andrastantos/jtag_2232h/ALTIUM_EMBEDDED_MODELS/ASE-xxxMHZ.stp

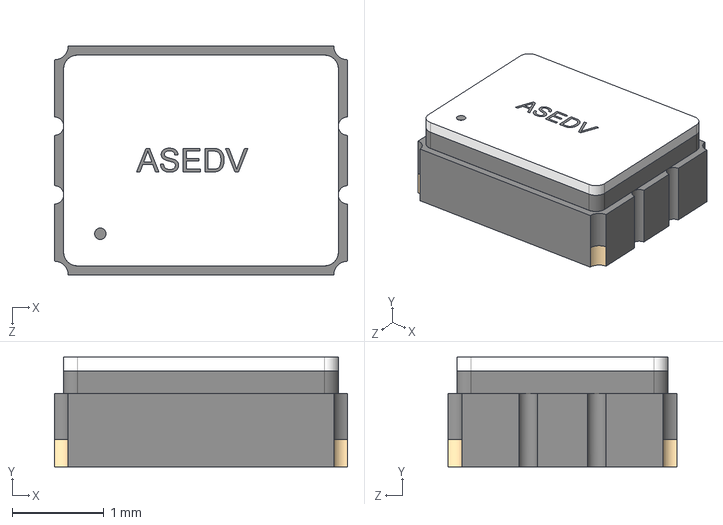
[picture p1: CAD file, 2024-08-22]
ALTIUM_EMBEDDED_MODELS/ASE-xxxMHZ.stp
3.20 x 1.20 x 2.50 mm
