andrastantos/jtag_2232h/ALTIUM_EMBEDDED_MODELS/APTB1615.STEP

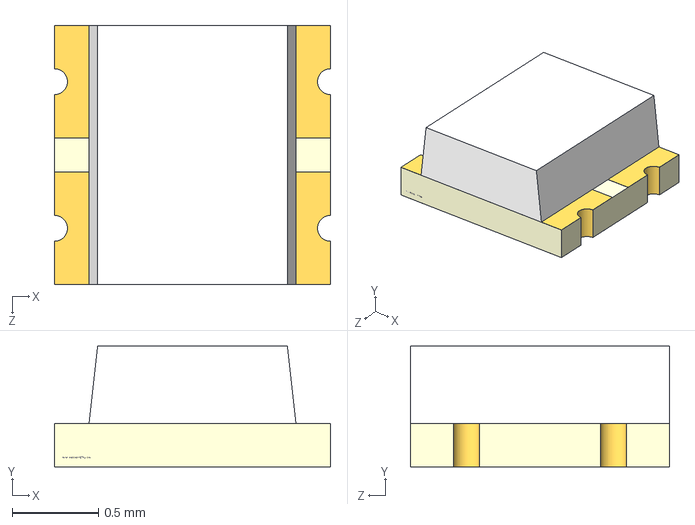
[picture p2: CAD file, 2024-08-21]
ALTIUM_EMBEDDED_MODELS/APTB1615.STEP
1.60 x 0.7 x 1.50 mm
