andrastantos/jtag_2232h/ALTIUM_EMBEDDED_MODELS/m50-3000645_asm.stp

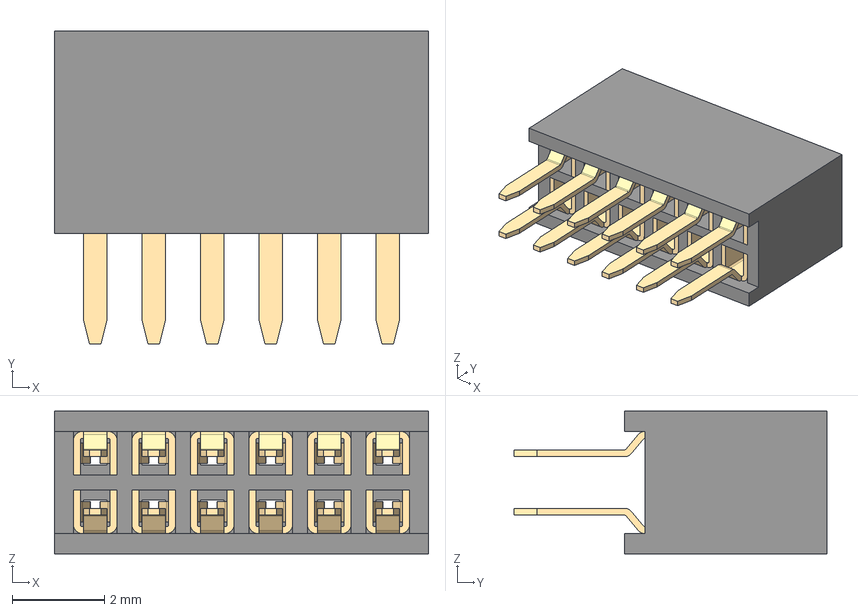
[picture p3: CAD file, 2024-08-21]
ALTIUM_EMBEDDED_MODELS/m50-3000645_asm.stp
8.12 x 6.80 x 3.10 mm
M50-300-MOULD
M50-300-CONTACT x 12
