andrastantos/jtag_2232h/ALTIUM_EMBEDDED_MODELS/473460001.stp

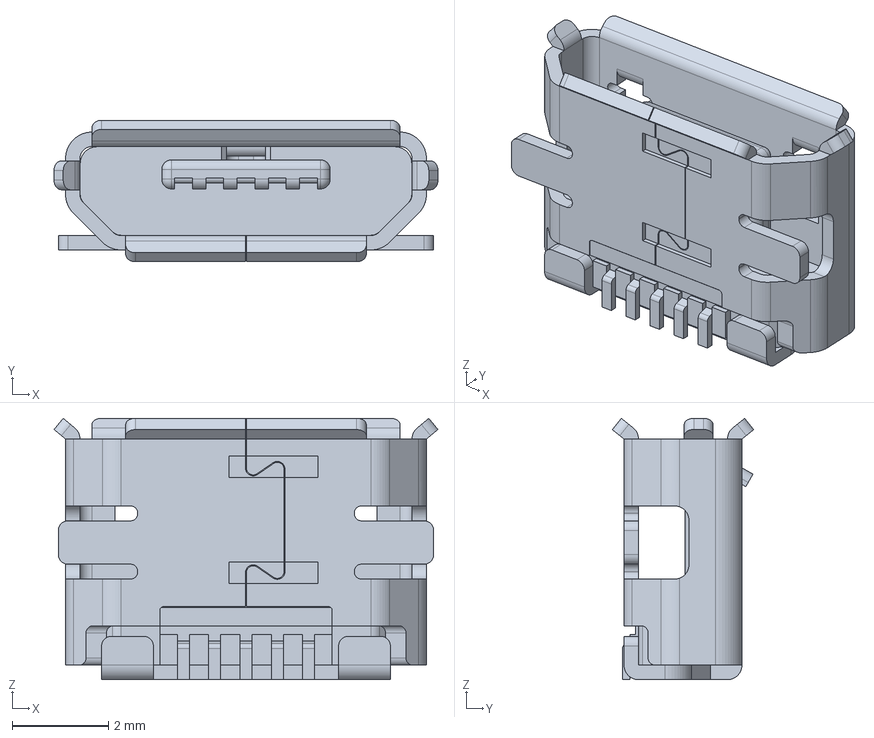
[picture p4: CAD file, 2024-08-21]
ALTIUM_EMBEDDED_MODELS/473460001.stp
7.98 x 2.94 x 5.43 mm
