andrastantos/jtag_2232h/jtag_2232h.kicad_pcb

## KiCad design jtag_2232h.kicad_pcb (2024-09-02)

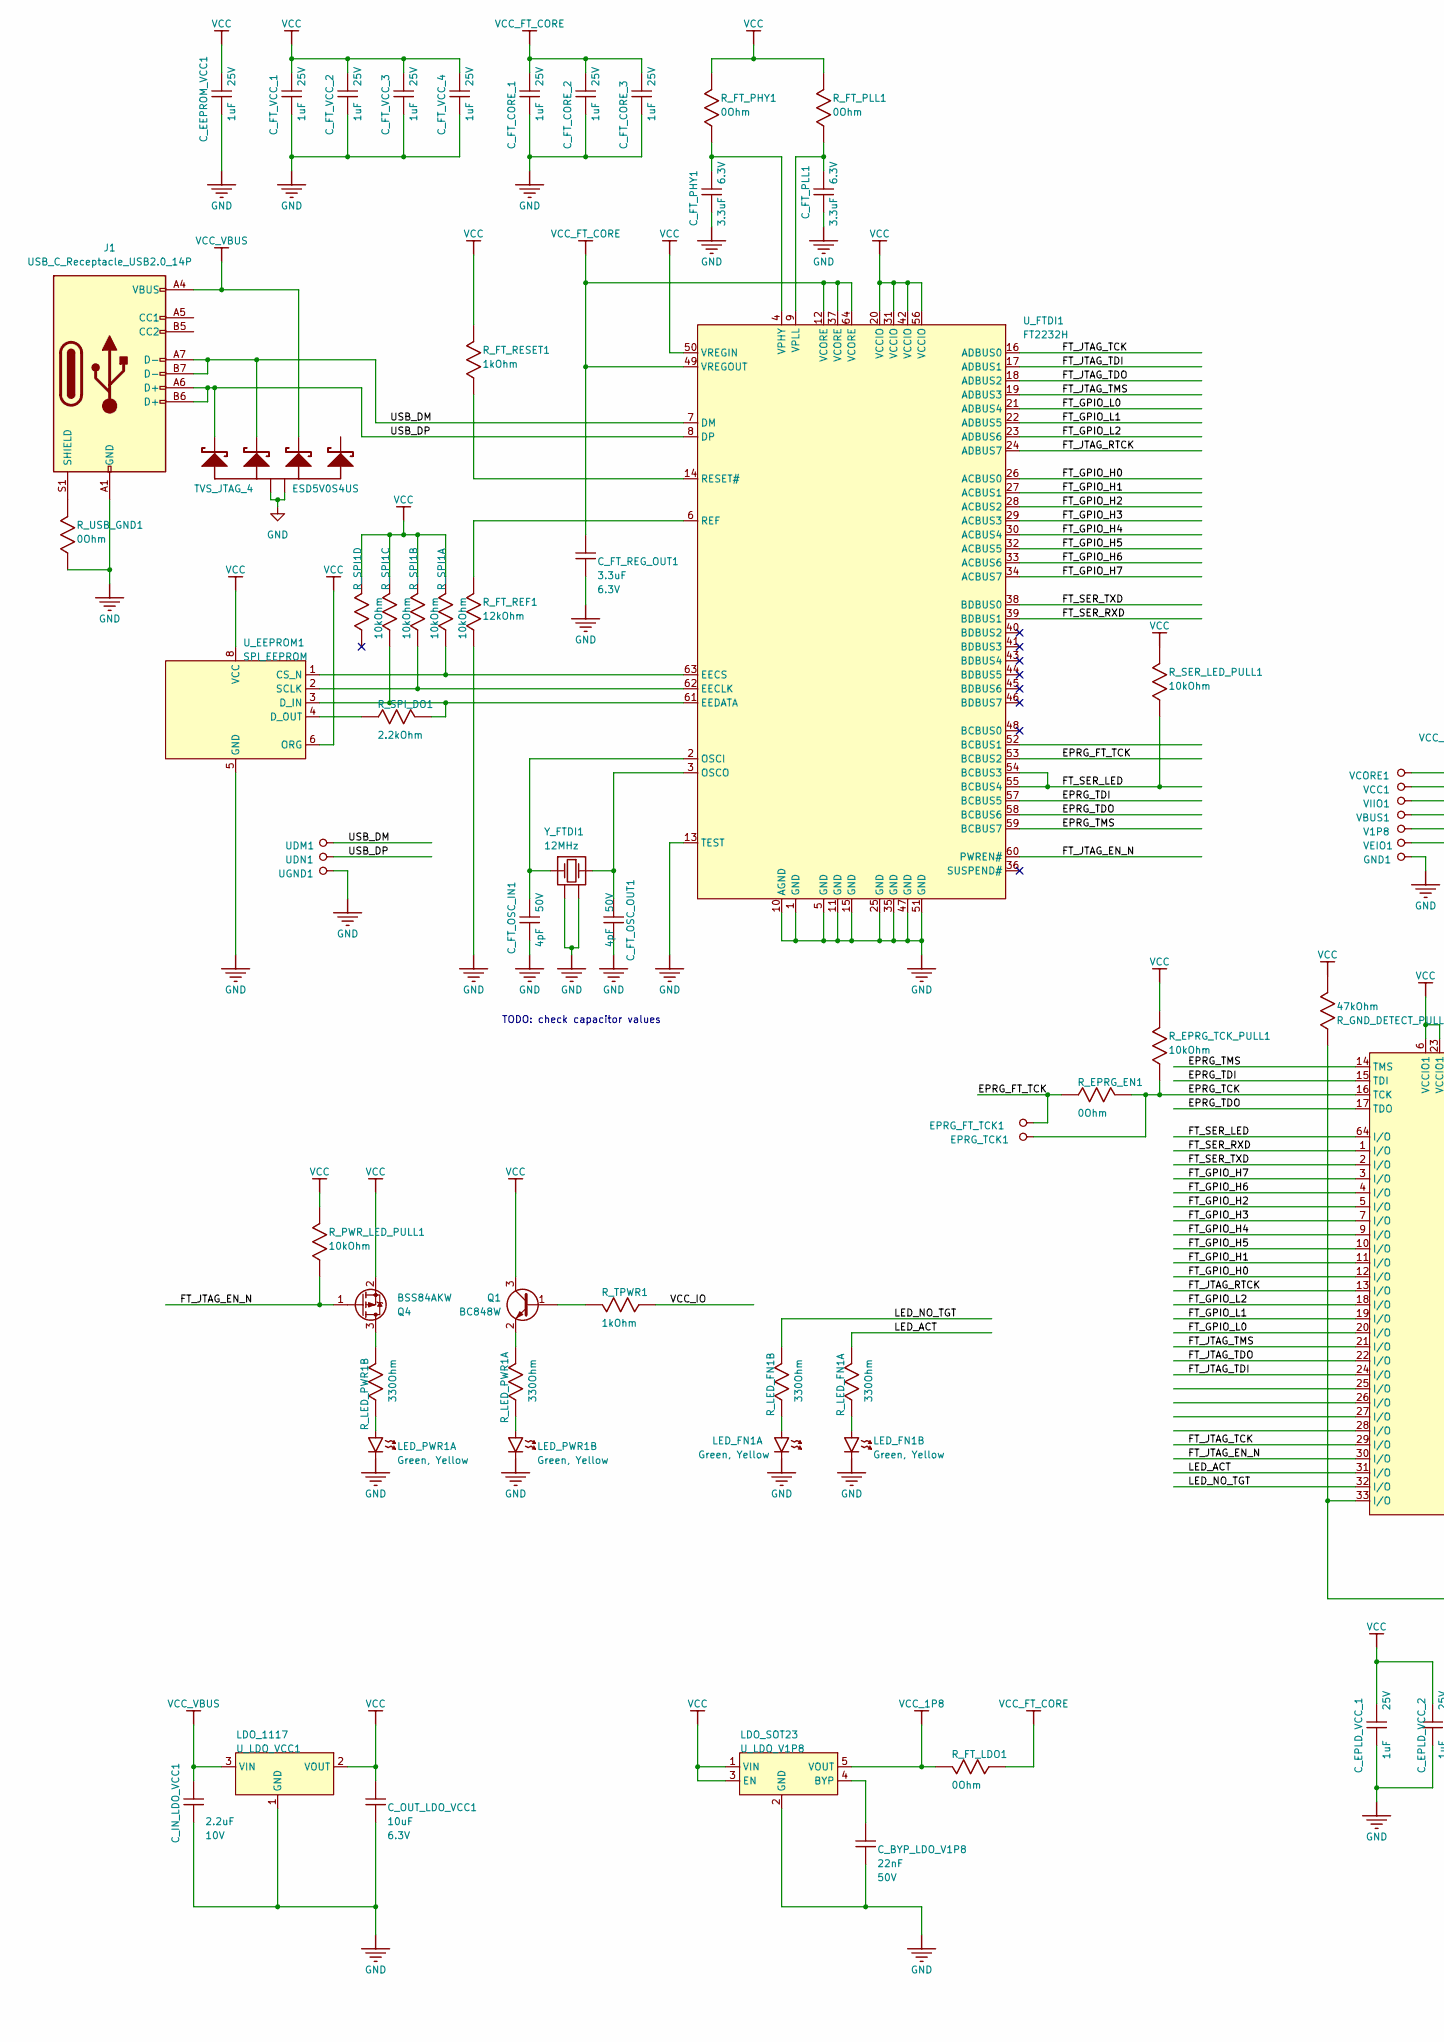
[picture p5: schematic jtag_2232h.kicad_sch, part in row 1, column 1]

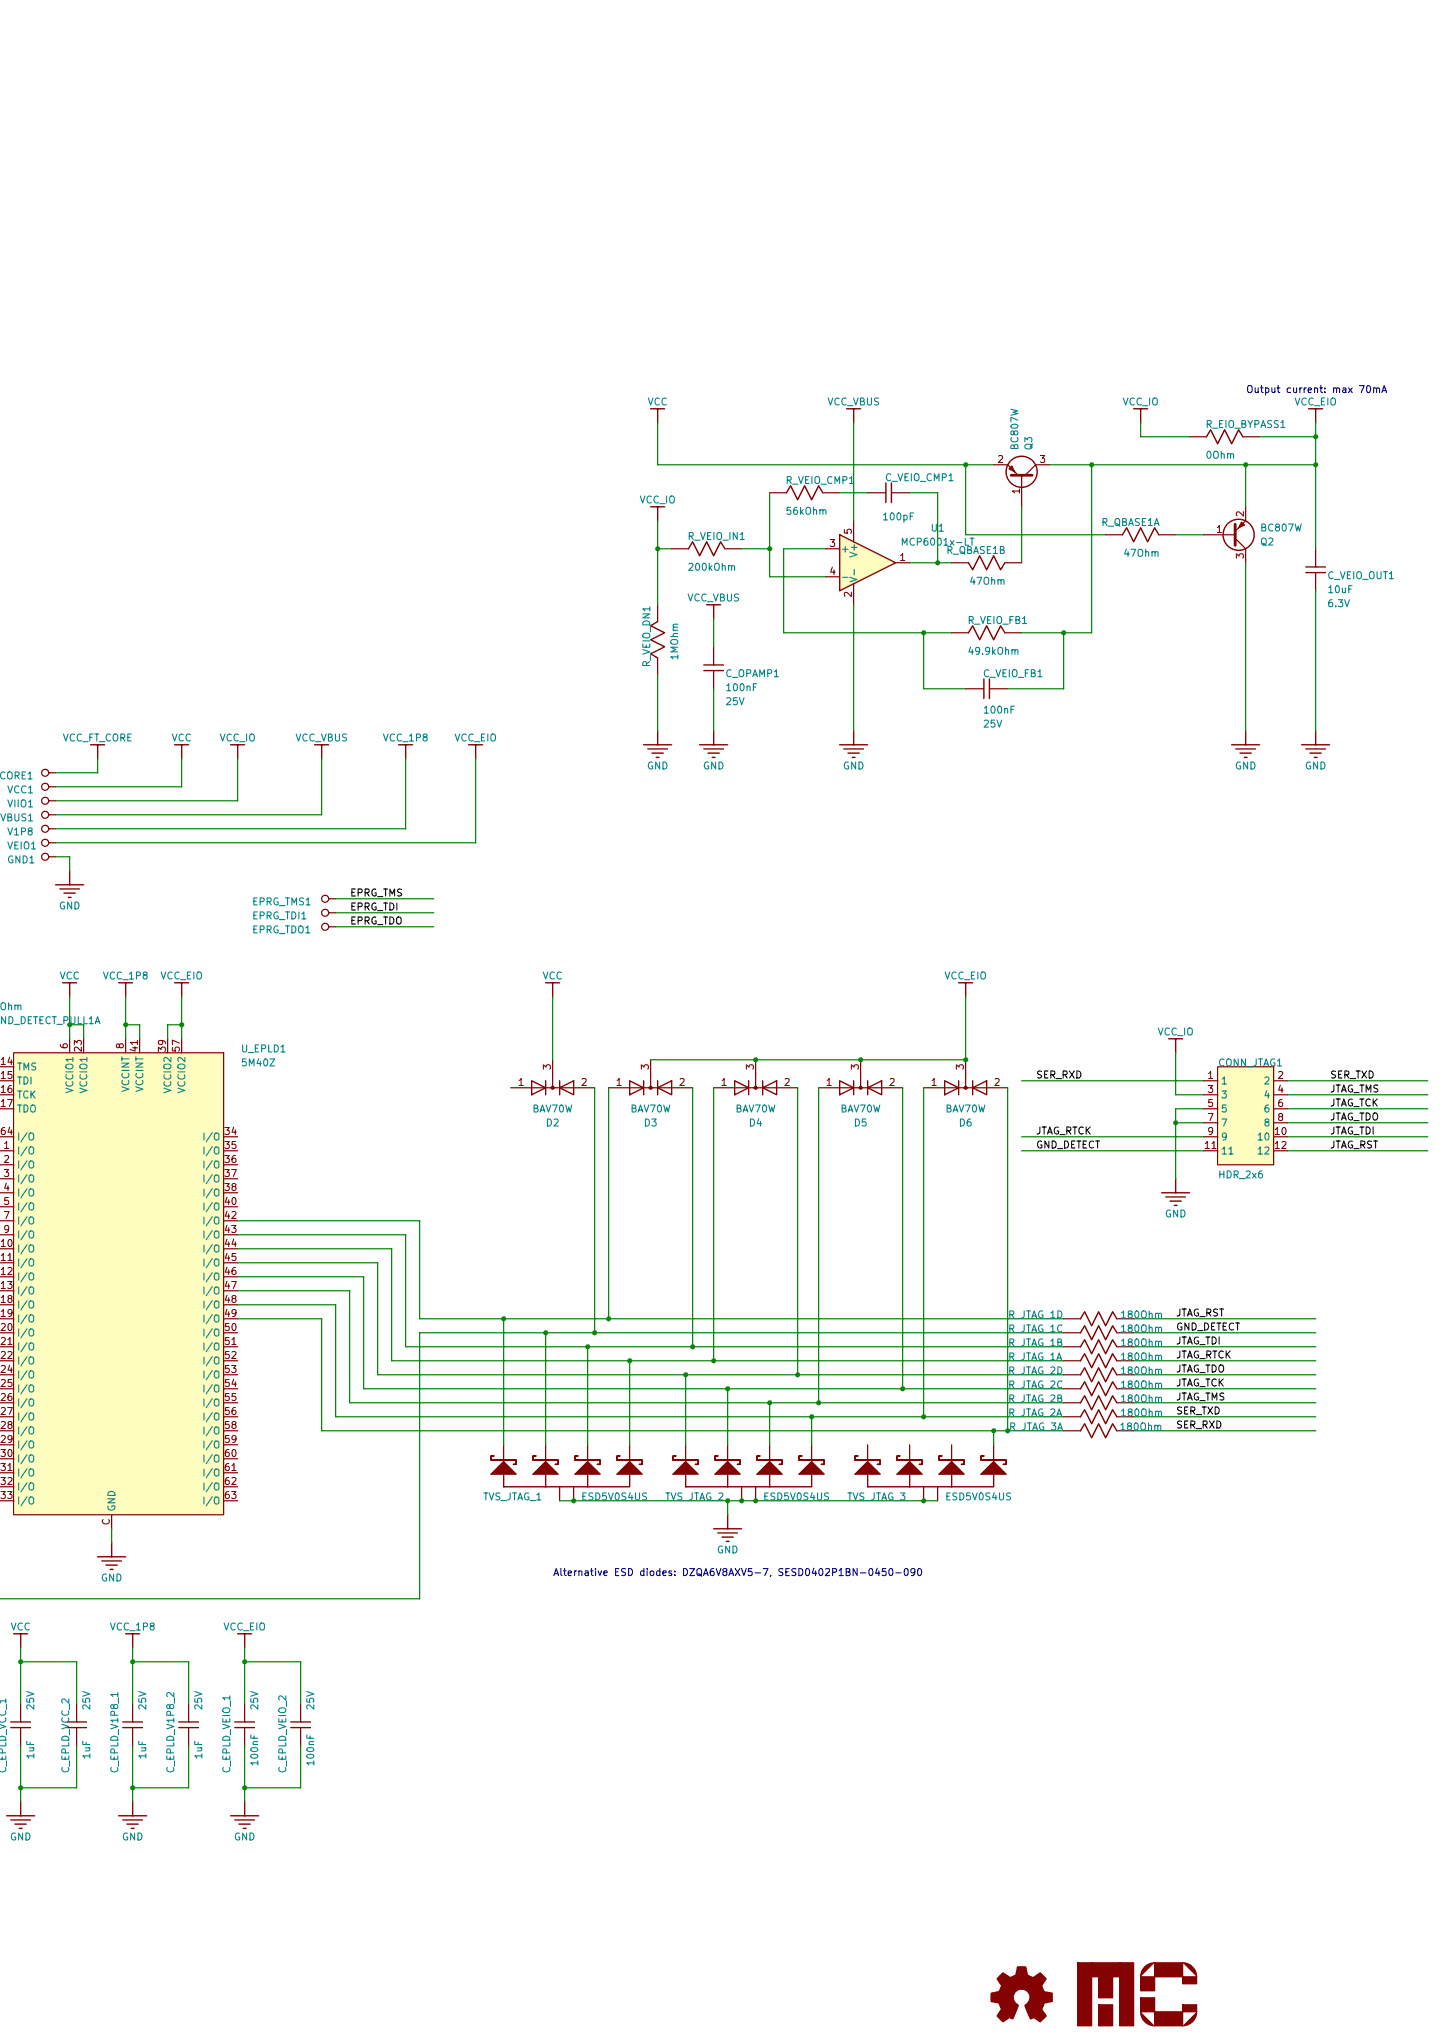
[picture p6: schematic jtag_2232h.kicad_sch, part in row 1, column 2]

Parts:
CONN_JTAG1: HDR_2x6; RCP_1P27_2X6_EDGE; MANUFACTURER PART NUMBER M50-3000645
C_BYP_LDO_V1P8: 22nF; C_0603_1608Metric_Pad1.08x0.95mm_HandSolder; VOLTAGE - RATED 50V; TOLERANCE +/-20%; MANUFACTURER PART NUMBER C1608X7R1H223M; DIGI-KEY PART NUMBER 445-5092-1-ND
C_EEPROM_VCC1: 1uF; C_0603_1608Metric_Pad1.08x0.95mm_HandSolder; VOLTAGE - RATED 25V; TOLERANCE +/-10%; MANUFACTURER PART NUMBER C1608X5R1E105K; DIGI-KEY PART NUMBER 445-5146-1-ND
C_EPLD_V1P8_1, C_EPLD_V1P8_2: 1uF; C_0603_1608Metric_Pad1.08x0.95mm_HandSolder; VOLTAGE - RATED 25V; TOLERANCE +/-10%; MANUFACTURER PART NUMBER C1608X5R1E105K; DIGI-KEY PART NUMBER 445-5146-1-ND
C_EPLD_VCC_1, C_EPLD_VCC_2: 1uF; C_0603_1608Metric_Pad1.08x0.95mm_HandSolder; VOLTAGE - RATED 25V; TOLERANCE +/-10%; MANUFACTURER PART NUMBER C1608X5R1E105K; DIGI-KEY PART NUMBER 445-5146-1-ND
C_EPLD_VEIO_1, C_EPLD_VEIO_2: 100nF; C_0603_1608Metric_Pad1.08x0.95mm_HandSolder; VOLTAGE - RATED 25V; TOLERANCE +/-10%; MANUFACTURER PART NUMBER C1608X7R1E104K; DIGI-KEY PART NUMBER 445-1316-1-ND
C_FT_CORE_1, C_FT_CORE_2, C_FT_CORE_3: 1uF; C_0603_1608Metric_Pad1.08x0.95mm_HandSolder; VOLTAGE - RATED 25V; TOLERANCE +/-10%; MANUFACTURER PART NUMBER C1608X5R1E105K; DIGI-KEY PART NUMBER 445-5146-1-ND
C_FT_OSC_IN1: 4pF; C_0603_1608Metric_Pad1.08x0.95mm_HandSolder; VOLTAGE - RATED 50V; TOLERANCE +/-0.25pF; MANUFACTURER PART NUMBER C1608C0G1H040C; DIGI-KEY PART NUMBER 445-5029-1-ND
C_FT_OSC_OUT1: 4pF; C_0603_1608Metric_Pad1.08x0.95mm_HandSolder; VOLTAGE - RATED 50V; TOLERANCE +/-0.25pF; MANUFACTURER PART NUMBER C1608C0G1H040C; DIGI-KEY PART NUMBER 445-5029-1-ND
C_FT_PHY1: 3.3uF; C_0603_1608Metric_Pad1.08x0.95mm_HandSolder; VOLTAGE - RATED 6.3V; TOLERANCE +/-10%; MANUFACTURER PART NUMBER C1608X5R0J335K; DIGI-KEY PART NUMBER 445-5176-1-ND
C_FT_PLL1: 3.3uF; C_0603_1608Metric_Pad1.08x0.95mm_HandSolder; VOLTAGE - RATED 6.3V; TOLERANCE +/-10%; MANUFACTURER PART NUMBER C1608X5R0J335K; DIGI-KEY PART NUMBER 445-5176-1-ND
C_FT_REG_OUT1: 3.3uF; C_0603_1608Metric_Pad1.08x0.95mm_HandSolder; VOLTAGE - RATED 6.3V; TOLERANCE +/-10%; MANUFACTURER PART NUMBER C1608X5R0J335K; DIGI-KEY PART NUMBER 445-5176-1-ND
C_FT_VCC_1, C_FT_VCC_2, C_FT_VCC_3, C_FT_VCC_4: 1uF; C_0603_1608Metric_Pad1.08x0.95mm_HandSolder; VOLTAGE - RATED 25V; TOLERANCE +/-10%; MANUFACTURER PART NUMBER C1608X5R1E105K; DIGI-KEY PART NUMBER 445-5146-1-ND
C_IN_LDO_VCC1: 2.2uF; C_0603_1608Metric_Pad1.08x0.95mm_HandSolder; VOLTAGE - RATED 10V; TOLERANCE +/-10%; MANUFACTURER PART NUMBER C1608X5R1A225K; DIGI-KEY PART NUMBER 445-5166-1-ND
C_OPAMP1: 100nF; C_0603_1608Metric_Pad1.08x0.95mm_HandSolder; VOLTAGE - RATED 25V; TOLERANCE +/-10%; MANUFACTURER PART NUMBER C1608X7R1E104K; DIGI-KEY PART NUMBER 445-1316-1-ND
C_OUT_LDO_VCC1: 10uF; C_0603_1608Metric_Pad1.08x0.95mm_HandSolder; VOLTAGE - RATED 6.3V; TOLERANCE +/-20%; MANUFACTURER PART NUMBER C1608X5R0J106M; DIGI-KEY PART NUMBER 445-4112-1-ND
C_VEIO_CMP1: 100pF; C_0603_1608Metric_Pad1.08x0.95mm_HandSolder; VOLTAGE - RATED 50V; TOLERANCE +/-5%; MANUFACTURER PART NUMBER C1608C0G1H101J; DIGI-KEY PART NUMBER 445-1281-1-ND
C_VEIO_FB1: 100nF; C_0603_1608Metric_Pad1.08x0.95mm_HandSolder; VOLTAGE - RATED 25V; TOLERANCE +/-10%; MANUFACTURER PART NUMBER C1608X7R1E104K; DIGI-KEY PART NUMBER 445-1316-1-ND
C_VEIO_OUT1: 10uF; C_0603_1608Metric_Pad1.08x0.95mm_HandSolder; VOLTAGE - RATED 6.3V; TOLERANCE +/-20%; MANUFACTURER PART NUMBER C1608X5R0J106M; DIGI-KEY PART NUMBER 445-4112-1-ND
D2, D3, D4, D5, D6: BAV70W; SOT-323_SC-70
EPRG_FT_TCK1: Test_Point; TEST_POINT_100
EPRG_TCK1: Test_Point; TEST_POINT_100
EPRG_TDI1: Test_Point; TEST_POINT_100
EPRG_TDO1: Test_Point; TEST_POINT_100
EPRG_TMS1: Test_Point; TEST_POINT_100
GND1: Test_Point; TEST_POINT_100
J1: USB_C_Receptacle_USB2.0_14P; USB_C_Receptacle_HRO_TYPE-C-31-M-12; mpn USB4215-03-A
LED_FN1: LED_2; LEDX2_150X160X55; MANUFACTURER PART NUMBER APTB1612YSGC-F01
LED_PWR1: LED_2; LEDX2_150X160X55; MANUFACTURER PART NUMBER APTB1612YSGC-F01
LOGO1: MC_logo_micro
Q1: BC848W; SOT-323_SC-70
Q2, Q3: BC807W; SOT-323_SC-70
Q4: BSS84AKW; SOT-323_SC-70
R_EIO_BYPASS1: 0Ohm; R_0603_1608Metric_Pad0.98x0.95mm_HandSolder; TOLERANCE Jumper; MANUFACTURER PART NUMBER RMCF0603ZT0R00; DIGI-KEY PART NUMBER RMCF0603ZT0R00CT-ND
R_EPRG_EN1: 0Ohm; R_0603_1608Metric_Pad0.98x0.95mm_HandSolder; TOLERANCE Jumper; MANUFACTURER PART NUMBER RMCF0603ZT0R00; DIGI-KEY PART NUMBER RMCF0603ZT0R00CT-ND
R_EPRG_TCK_PULL1: 10kOhm; R_0603_1608Metric_Pad0.98x0.95mm_HandSolder; TOLERANCE +/-1%; MANUFACTURER PART NUMBER RMCF0603FT10K0; DIGI-KEY PART NUMBER RMCF0603FT10K0CT-ND
R_FT_LDO1: 0Ohm; R_0603_1608Metric_Pad0.98x0.95mm_HandSolder; TOLERANCE Jumper; MANUFACTURER PART NUMBER RMCF0603ZT0R00; DIGI-KEY PART NUMBER RMCF0603ZT0R00CT-ND
R_FT_PHY1: 0Ohm; R_0603_1608Metric_Pad0.98x0.95mm_HandSolder; TOLERANCE Jumper; MANUFACTURER PART NUMBER RMCF0603ZT0R00; DIGI-KEY PART NUMBER RMCF0603ZT0R00CT-ND
R_FT_PLL1: 0Ohm; R_0603_1608Metric_Pad0.98x0.95mm_HandSolder; TOLERANCE Jumper; MANUFACTURER PART NUMBER RMCF0603ZT0R00; DIGI-KEY PART NUMBER RMCF0603ZT0R00CT-ND
R_FT_REF1: 12kOhm; R_0603_1608Metric_Pad0.98x0.95mm_HandSolder; TOLERANCE +/-1%; MANUFACTURER PART NUMBER RMCF0603FT12K0; DIGI-KEY PART NUMBER RMCF0603FT12K0CT-ND
R_FT_RESET1: 1kOhm; R_0603_1608Metric_Pad0.98x0.95mm_HandSolder; TOLERANCE +/-1%; MANUFACTURER PART NUMBER RMCF0603FT1K00; DIGI-KEY PART NUMBER RMCF0603FT1K00CT-ND
R_GND_DETECT_PULL1: 47kOhm; R_Array_Convex_2x0603; TOLERANCE +/-5%; MANUFACTURER PART NUMBER EXB-V4V473JV; DIGI-KEY PART NUMBER Y2473CT-ND
R_JTAG_1, R_JTAG_2: 180Ohm; R_Array_Convex_4x0603; TOLERANCE +/-5%; MANUFACTURER PART NUMBER EXB-V8V181JV; DIGI-KEY PART NUMBER Y4181CT-ND
R_JTAG_3: 180Ohm; R_Array_Convex_2x0603; TOLERANCE +/-5%; MANUFACTURER PART NUMBER EXB-V4V181JV; DIGI-KEY PART NUMBER Y2181CT-ND
R_LED_FN1: 330Ohm; R_Array_Convex_2x0603; TOLERANCE +/-5%; MANUFACTURER PART NUMBER EXB-V4V331JV; DIGI-KEY PART NUMBER Y2331CT-ND
R_LED_PWR1: 330Ohm; R_Array_Convex_2x0603; TOLERANCE +/-5%; MANUFACTURER PART NUMBER EXB-V4V331JV; DIGI-KEY PART NUMBER Y2331CT-ND
R_PWR_LED_PULL1: 10kOhm; R_0603_1608Metric_Pad0.98x0.95mm_HandSolder; TOLERANCE +/-1%; MANUFACTURER PART NUMBER RMCF0603FT10K0; DIGI-KEY PART NUMBER RMCF0603FT10K0CT-ND
R_QBASE1: 47Ohm; R_Array_Convex_2x0603; TOLERANCE +/-5%; MANUFACTURER PART NUMBER EXB-V4V470JV; DIGI-KEY PART NUMBER Y2470CT-ND
R_SER_LED_PULL1: 10kOhm; R_0603_1608Metric_Pad0.98x0.95mm_HandSolder; TOLERANCE +/-1%; MANUFACTURER PART NUMBER RMCF0603FT10K0; DIGI-KEY PART NUMBER RMCF0603FT10K0CT-ND
R_SPI1: 10kOhm; R_Array_Convex_4x0603; TOLERANCE +/-5%; MANUFACTURER PART NUMBER EXB-V8V103JV; DIGI-KEY PART NUMBER Y4103CT-ND
R_SPI_DO1: 2.2kOhm; R_0603_1608Metric_Pad0.98x0.95mm_HandSolder; TOLERANCE +/-5%; MANUFACTURER PART NUMBER RMCF0603JT2K20; DIGI-KEY PART NUMBER RMCF0603JT2K20CT-ND
R_TPWR1: 1kOhm; R_0603_1608Metric_Pad0.98x0.95mm_HandSolder; TOLERANCE +/-1%; MANUFACTURER PART NUMBER RMCF0603FT1K00; DIGI-KEY PART NUMBER RMCF0603FT1K00CT-ND
R_USB_GND1: 0Ohm; R_0603_1608Metric_Pad0.98x0.95mm_HandSolder; TOLERANCE Jumper; MANUFACTURER PART NUMBER RMCF0603ZT0R00; DIGI-KEY PART NUMBER RMCF0603ZT0R00CT-ND
R_VEIO_CMP1: 56kOhm; R_0603_1608Metric_Pad0.98x0.95mm_HandSolder; TOLERANCE +/-5%; MANUFACTURER PART NUMBER RMCF0603JG56K0; DIGI-KEY PART NUMBER RMCF0603JG56K0CT-ND
R_VEIO_DN1: 1MOhm; R_0603_1608Metric_Pad0.98x0.95mm_HandSolder; TOLERANCE +/-1%; MANUFACTURER PART NUMBER RMCF0603FT1M00; DIGI-KEY PART NUMBER RMCF0603FT1M00CT-ND
R_VEIO_FB1: 49.9kOhm; R_0603_1608Metric_Pad0.98x0.95mm_HandSolder; TOLERANCE +/-1%; MANUFACTURER PART NUMBER RMCF0603FT49K9; DIGI-KEY PART NUMBER RMCF0603FT49K9CT-ND
R_VEIO_IN1: 200kOhm; R_0603_1608Metric_Pad0.98x0.95mm_HandSolder; TOLERANCE +/-5%; MANUFACTURER PART NUMBER RMCF0603JT200K; DIGI-KEY PART NUMBER RMCF0603JT200KCT-ND
TVS_JTAG_1, TVS_JTAG_2, TVS_JTAG_3, TVS_JTAG_4: ESD5V0S4US; SOT-363_SC-70-6
U1: MCP6001x-LT; SOT-353_SC-70-5
UDM1: Test_Point; TEST_POINT_100
UDN1: Test_Point; TEST_POINT_100
UGND1: Test_Point; TEST_POINT_100
U_EEPROM1: SPI_EEPROM; TSSOP-8_4.4x3mm_P0.65mm; MANUFACTURER PART NUMBER AT93C46D-TH-B
U_EPLD1: 5M40Z; TSQFP40P900X900X120_HS_64N
U_FTDI1: FT2232H; LQFP-64_10x10mm_P0.5mm
U_LDO_V1P8: LDO_SOT23; SOT-23-5; OUTPUT VOLTAGE (V) 1.8; INPUT VOLTAGE MIN (V) 1.8; MANUFACTURER PART NUMBER PT7M8206B18TA5EX
U_LDO_VCC1: LDO_1117; SOT-89-3_Handsoldering; OUTPUT VOLTAGE (V) 3.3; INPUT VOLTAGE MIN (V) 2.75; MANUFACTURER PART NUMBER AP1117Y33G-13
V1P8: Test_Point; TEST_POINT_100
VBUS1: Test_Point; TEST_POINT_100
VCC1: Test_Point; TEST_POINT_100
VCORE1: Test_Point; TEST_POINT_100
VEIO1: Test_Point; TEST_POINT_100
VIIO1: Test_Point; TEST_POINT_100
Y_FTDI1: XTAL_4P; XTAL_4P_3P2x2P5; TOLERANCE 15ppm

Connections:
/EPRG_FT_TCK: EPRG_FT_TCK1.1, R_EPRG_EN1.1, U_FTDI1.53 (BCBUS2)
/EPRG_TCK: EPRG_TCK1.1, R_EPRG_EN1.2, R_EPRG_TCK_PULL1.1, U_EPLD1.16 (TCK)
/EPRG_TDI: EPRG_TDI1.1, U_EPLD1.15 (TDI), U_FTDI1.57 (BCBUS5)
/EPRG_TDO: EPRG_TDO1.1, U_EPLD1.17 (TDO), U_FTDI1.58 (BCBUS6)
/EPRG_TMS: EPRG_TMS1.1, U_EPLD1.14 (TMS), U_FTDI1.59 (BCBUS7)
/FT_GPIO_H0: U_EPLD1.12 (I/O), U_FTDI1.26 (ACBUS0)
/FT_GPIO_H1: U_EPLD1.11 (I/O), U_FTDI1.27 (ACBUS1)
/FT_GPIO_H2: U_EPLD1.5 (I/O), U_FTDI1.28 (ACBUS2)
/FT_GPIO_H3: U_EPLD1.7 (I/O), U_FTDI1.29 (ACBUS3)
/FT_GPIO_H4: U_EPLD1.9 (I/O), U_FTDI1.30 (ACBUS4)
/FT_GPIO_H5: U_EPLD1.10 (I/O), U_FTDI1.32 (ACBUS5)
/FT_GPIO_H6: U_EPLD1.4 (I/O), U_FTDI1.33 (ACBUS6)
/FT_GPIO_H7: U_EPLD1.3 (I/O), U_FTDI1.34 (ACBUS7)
/FT_GPIO_L0: U_EPLD1.20 (I/O), U_FTDI1.21 (ADBUS4)
/FT_GPIO_L1: U_EPLD1.19 (I/O), U_FTDI1.22 (ADBUS5)
/FT_GPIO_L2: U_EPLD1.18 (I/O), U_FTDI1.23 (ADBUS6)
/FT_JTAG_EN_N: Q4.1 (G), R_PWR_LED_PULL1.1, U_EPLD1.30 (I/O), U_FTDI1.60 (PWREN#)
/FT_JTAG_RTCK: U_EPLD1.13 (I/O), U_FTDI1.24 (ADBUS7)
/FT_JTAG_TCK: U_EPLD1.29 (I/O), U_FTDI1.16 (ADBUS0)
/FT_JTAG_TDI: U_EPLD1.24 (I/O), U_FTDI1.17 (ADBUS1)
/FT_JTAG_TDO: U_EPLD1.22 (I/O), U_FTDI1.18 (ADBUS2)
/FT_JTAG_TMS: U_EPLD1.21 (I/O), U_FTDI1.19 (ADBUS3)
/FT_SER_LED: R_SER_LED_PULL1.1, U_EPLD1.64 (I/O), U_FTDI1.54 (BCBUS3), U_FTDI1.55 (BCBUS4)
/FT_SER_RXD: U_EPLD1.1 (I/O), U_FTDI1.39 (BDBUS1)
/FT_SER_TXD: U_EPLD1.2 (I/O), U_FTDI1.38 (BDBUS0)
/GND_DETECT: CONN_JTAG1.11, R_JTAG_1.6
/JTAG_RST: CONN_JTAG1.12, R_JTAG_1.5
/JTAG_RTCK: CONN_JTAG1.9, R_JTAG_1.8
/JTAG_TCK: CONN_JTAG1.6, R_JTAG_2.6
/JTAG_TDI: CONN_JTAG1.10, R_JTAG_1.7
/JTAG_TDO: CONN_JTAG1.8, R_JTAG_2.5
/JTAG_TMS: CONN_JTAG1.4, R_JTAG_2.7
/LED_ACT: R_LED_FN1.4, U_EPLD1.31 (I/O)
/LED_NO_TGT: R_LED_FN1.3, U_EPLD1.32 (I/O)
/SER_RXD: CONN_JTAG1.1, R_JTAG_3.1
/SER_TXD: CONN_JTAG1.2, R_JTAG_2.8
/USB_DM: J1.A7 (D-), J1.B7 (D-), TVS_JTAG_4.3 (K), UDM1.1, U_FTDI1.7 (DM)
/USB_DP: J1.A6 (D+), J1.B6 (D+), TVS_JTAG_4.1 (K), UDN1.1, U_FTDI1.8 (DP)
GND: CONN_JTAG1.5, CONN_JTAG1.7, C_BYP_LDO_V1P8.1, C_EEPROM_VCC1.2, C_EPLD_V1P8_1.2, C_EPLD_V1P8_2.2, C_EPLD_VCC_1.2, C_EPLD_VCC_2.2, C_EPLD_VEIO_1.2, C_EPLD_VEIO_2.2, C_FT_CORE_1.2, C_FT_CORE_2.2, C_FT_CORE_3.2, C_FT_OSC_IN1.2, C_FT_OSC_OUT1.2, C_FT_PHY1.2, C_FT_PLL1.2, C_FT_REG_OUT1.2, C_FT_VCC_1.2, C_FT_VCC_2.2, C_FT_VCC_3.2, C_FT_VCC_4.2, C_IN_LDO_VCC1.2, C_OPAMP1.2, C_OUT_LDO_VCC1.2, C_VEIO_OUT1.2, GND1.1, J1.A1 (GND), J1.A12 (GND), J1.B1 (GND), J1.B12 (GND), LED_FN1.C1, LED_FN1.C2, LED_PWR1.C1, LED_PWR1.C2, Q2.3 (C), R_FT_REF1.1, R_USB_GND1.1, R_VEIO_DN1.1, TVS_JTAG_1.2 (A), TVS_JTAG_1.5 (A), TVS_JTAG_2.2 (A), TVS_JTAG_2.5 (A), TVS_JTAG_3.2 (A), TVS_JTAG_3.5 (A), TVS_JTAG_4.2 (A), TVS_JTAG_4.5 (A), U1.2 (V-), UGND1.1, U_EEPROM1.5 (GND), U_EPLD1.C (GND), U_FTDI1.1 (GND), U_FTDI1.5 (GND), U_FTDI1.10 (AGND), U_FTDI1.11 (GND), U_FTDI1.13 (TEST), U_FTDI1.15 (GND), U_FTDI1.25 (GND), U_FTDI1.35 (GND), U_FTDI1.47 (GND), U_FTDI1.51 (GND), U_LDO_V1P8.2 (GND), U_LDO_VCC1.1 (GND), Y_FTDI1.2, Y_FTDI1.4
unnamed: C_VEIO_CMP1.1, R_VEIO_CMP1.2
unnamed: C_VEIO_CMP1.2, R_QBASE1.2, U1.1
unnamed: D2.2 (A), R_GND_DETECT_PULL1.4, R_JTAG_1.3, TVS_JTAG_1.3 (K), U_EPLD1.33 (I/O)
unnamed: D3.1 (A), R_JTAG_1.4, TVS_JTAG_1.1 (K), U_EPLD1.42 (I/O)
unnamed: D3.2 (A), R_JTAG_1.2, TVS_JTAG_1.4 (K), U_EPLD1.43 (I/O)
unnamed: D4.1 (A), R_JTAG_1.1, TVS_JTAG_1.6 (K), U_EPLD1.44 (I/O)
unnamed: D4.2 (A), R_JTAG_2.4, TVS_JTAG_2.1 (K), U_EPLD1.45 (I/O)
unnamed: D5.1 (A), R_JTAG_2.2, TVS_JTAG_2.4 (K), U_EPLD1.47 (I/O)
unnamed: D5.2 (A), R_JTAG_2.3, TVS_JTAG_2.3 (K), U_EPLD1.46 (I/O)
unnamed: D6.1 (A), R_JTAG_2.1, TVS_JTAG_2.6 (K), U_EPLD1.48 (I/O)
unnamed: D6.2 (A), R_JTAG_3.4, TVS_JTAG_3.6 (K), U_EPLD1.49 (I/O)
unnamed: J1.S1 (SHIELD), R_USB_GND1.2
unnamed: LED_FN1.A1, R_LED_FN1.2
unnamed: LED_FN1.A2, R_LED_FN1.1
unnamed: LED_PWR1.A1, R_LED_PWR1.2
unnamed: LED_PWR1.A2, R_LED_PWR1.1
unnamed: Q1.1 (B), R_TPWR1.2
unnamed: Q1.2 (E), R_LED_PWR1.4
unnamed: Q2.1 (B), R_QBASE1.1
unnamed: Q3.1 (B), R_QBASE1.3
unnamed: Q4.3 (D), R_LED_PWR1.3
unnamed: C_VEIO_FB1.1, R_VEIO_FB1.1, U1.3 (+)
unnamed: R_VEIO_CMP1.1, R_VEIO_IN1.2, U1.4 (-)
unnamed: R_SPI1.1, U_EEPROM1.1 (CS_N), U_FTDI1.63 (EECS)
unnamed: R_SPI1.3, R_SPI_DO1.2, U_EEPROM1.3 (D_IN), U_FTDI1.61 (EEDATA)
unnamed: R_SPI_DO1.1, U_EEPROM1.4 (D_OUT)
unnamed: R_SPI1.2, U_EEPROM1.2 (SCLK), U_FTDI1.62 (EECLK)
unnamed: C_FT_OSC_IN1.1, U_FTDI1.2 (OSCI), Y_FTDI1.1
unnamed: C_FT_OSC_OUT1.1, U_FTDI1.3 (OSCO), Y_FTDI1.3
unnamed: R_FT_REF1.2, U_FTDI1.6 (REF)
unnamed: R_FT_RESET1.1, U_FTDI1.14 (RESET#)
unnamed: C_FT_PHY1.1, R_FT_PHY1.1, U_FTDI1.4 (VPHY)
unnamed: C_FT_PLL1.1, R_FT_PLL1.1, U_FTDI1.9 (VPLL)
unnamed: C_BYP_LDO_V1P8.2, U_LDO_V1P8.4 (BYP)
VCC: C_EEPROM_VCC1.1, C_EPLD_VCC_1.1, C_EPLD_VCC_2.1, C_FT_VCC_1.1, C_FT_VCC_2.1, C_FT_VCC_3.1, C_FT_VCC_4.1, C_OUT_LDO_VCC1.1, D2.3 (K), Q1.3 (C), Q3.2 (E), Q4.2 (S), R_EPRG_TCK_PULL1.2, R_FT_PHY1.2, R_FT_PLL1.2, R_FT_RESET1.2, R_GND_DETECT_PULL1.1, R_PWR_LED_PULL1.2, R_QBASE1.4, R_SER_LED_PULL1.2, R_SPI1.5, R_SPI1.6, R_SPI1.7, R_SPI1.8, U_EEPROM1.6 (ORG), U_EEPROM1.8 (VCC), U_EPLD1.6 (VCCIO1), U_EPLD1.23 (VCCIO1), U_FTDI1.20 (VCCIO), U_FTDI1.31 (VCCIO), U_FTDI1.42 (VCCIO), U_FTDI1.50 (VREGIN), U_FTDI1.56 (VCCIO), U_LDO_V1P8.1 (VIN), U_LDO_V1P8.3 (EN), U_LDO_VCC1.2 (VOUT), VCC1.1
VCC_1P8: C_EPLD_V1P8_1.1, C_EPLD_V1P8_2.1, R_FT_LDO1.2, U_EPLD1.8 (VCCINT), U_EPLD1.41 (VCCINT), U_LDO_V1P8.5 (VOUT), V1P8.1
VCC_EIO: C_EPLD_VEIO_1.1, C_EPLD_VEIO_2.1, C_VEIO_FB1.2, C_VEIO_OUT1.1, D3.3 (K), D4.3 (K), D5.3 (K), D6.3 (K), Q2.2 (E), Q3.3 (C), R_EIO_BYPASS1.2, R_VEIO_FB1.2, U_EPLD1.39 (VCCIO2), U_EPLD1.57 (VCCIO2), VEIO1.1
VCC_FT_CORE: C_FT_CORE_1.1, C_FT_CORE_2.1, C_FT_CORE_3.1, C_FT_REG_OUT1.1, R_FT_LDO1.1, U_FTDI1.12 (VCORE), U_FTDI1.37 (VCORE), U_FTDI1.49 (VREGOUT), U_FTDI1.64 (VCORE), VCORE1.1
VCC_IO: CONN_JTAG1.3, R_EIO_BYPASS1.1, R_TPWR1.1, R_VEIO_DN1.2, R_VEIO_IN1.1, VIIO1.1
VCC_VBUS: C_IN_LDO_VCC1.1, C_OPAMP1.1, J1.A4 (VBUS), J1.A9 (VBUS), J1.B4 (VBUS), J1.B9 (VBUS), TVS_JTAG_4.4 (K), U1.5 (V+), U_LDO_VCC1.3 (VIN), VBUS1.1

Notes on the sheet:
Output current: max 70mA
TODO: check capacitor values
Alternative ESD diodes: DZQA6V8AXV5-7, SESD0402P1BN-0450-090

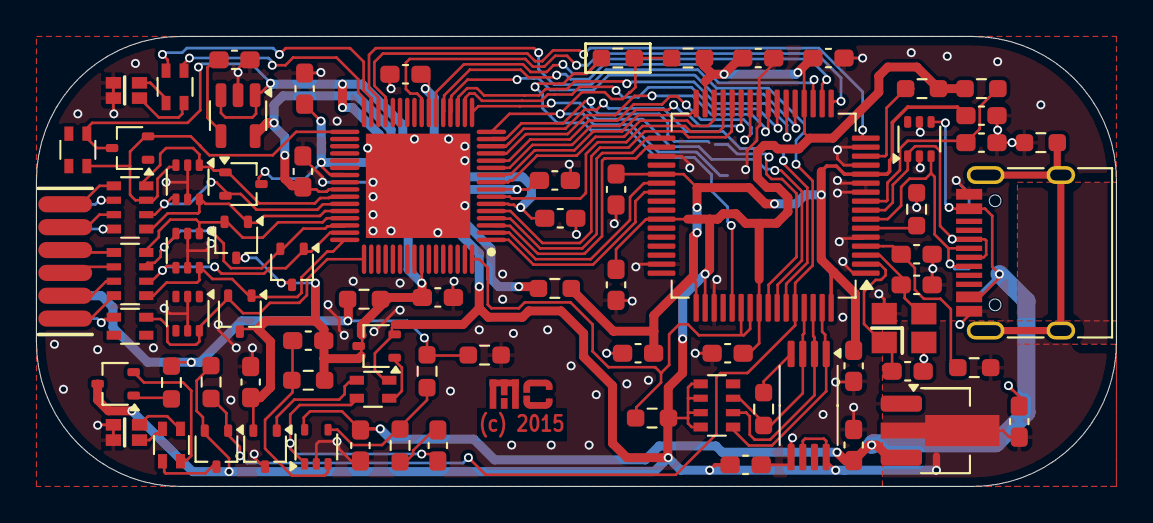
[picture p7: board jtag_2232h.kicad_pcb from above]

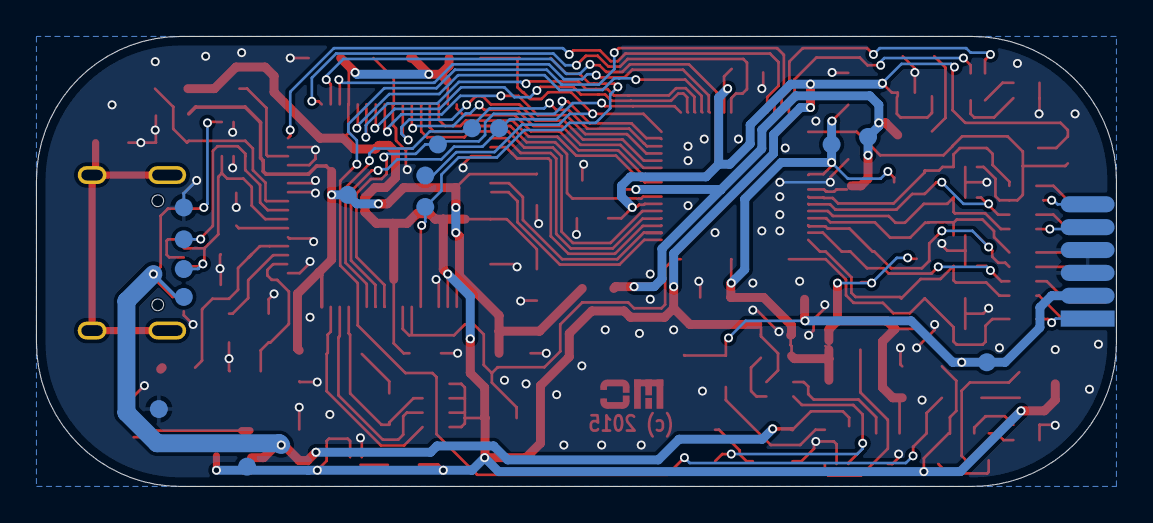
[picture p8: board jtag_2232h.kicad_pcb from below]

Board: 2 copper layers, 60.0 x 25.0 mm, 91 parts (15 on the bottom side), 79 nets.
