andrastantos/jtag_2232h/(commit log)

2024-08-21 Another import attempt.
    [jtag_2232h.kicad_pcb, jtag_2232h.kicad_sch]
2024-08-22 Annotated with modified KiCAD
    [jtag_2232h.kicad_pcb]
2024-08-22 Cleared all DRCs, mostly fixed up library.
    [ASE-xxxMHZ.stp, jtag_2232h.kicad_pcb, jtag_2232h.kicad_sch]
2024-09-02 Now using USB-C connector.
    Also using much more KiCAD-like components.
    [jtag_2232h.kicad_pcb, jtag_2232h.kicad_sch]
