andrastantos/jtag_2232h/(notices)

Notices in the files:
jtag_2232h.kicad_pcb:
(c) 2015
